wum747349-debug/LiIon-Charger-Protection-Board/hardware/README.md

# 硬件源文件与证据

只有实际工作或证据产生后，才创建对应的硬件子目录：

- `altium_project/`：权威 `.PrjPcb`、`.SchDoc`、`.PcbDoc` 和必要的项目库；
- `outputs/`：可追溯的原理图 PDF、BOM、报告和制造输出；
- `images/`：审查、装配、上电调试、测试和展示图片。

`.SchDoc` 和 `.PcbDoc` 是权威 EDA 实现源。目录、PDF、图片或文字设计意图不能证明 ERC、DRC、规则命中、铺铜状态或制造放行。用户负责实际 Altium 操作和导出；AI/Codex 只在明确限制下分析用户提供的证据。

不得仅为目录完整而创建空输出分类或低信息量占位文件。
