wum747349-debug/LiIon-Charger-Protection-Board/docs/module_design/README.md

# Stage 3 — Module Design Records

Status: Stage 3 documentation closeout complete — `READY FOR SCHEMATIC REVIEW`

## Current progress

| Module | Current status | Record |
| --- | --- | --- |
| M1 — USB-C Input / CC / Current Capability Control | COMPLETE FOR STAGE-3 HANDOFF | [m1_usb_c_input_cc_current_control.md](m1_usb_c_input_cc_current_control.md) |
| M2 — BQ25185 Charger / Power Path | COMPLETE FOR STAGE-3 HANDOFF | [m2_charger_power_path.md](m2_charger_power_path.md) |
| M3 — Battery + External NTC | COMPLETE FOR STAGE-3 HANDOFF | [m3_battery_external_ntc.md](m3_battery_external_ntc.md) |
| M4 — 3.3V Buck-Boost | COMPLETE FOR STAGE-3 HANDOFF | [m4_3v3_buck_boost.md](m4_3v3_buck_boost.md) |
| M5 — 3.3V Output Protection | COMPLETE FOR STAGE-3 HANDOFF | [m5_3v3_output_protection.md](m5_3v3_output_protection.md) |
| M6 — Remaining interfaces / support | COMPLETE FOR STAGE-3 HANDOFF | [m6_remaining_interfaces_support.md](m6_remaining_interfaces_support.md) |

用户已在 Altium Designer 中完成当前 M1–M6 Rev.A capture。Final Schematic Review、Cross-Module Integration Review 与 BOM Consistency Review 已完成；未发现新的 substantive cross-module electrical logic issue。Stage 5 documentation sync 已记录 M1/M5 current designator 与 L1 component delta；新 L1 footprint/pad mapping 仍需 EDA verification。Stage 3 canonical readiness 为 `READY FOR SCHEMATIC REVIEW`，技术评估为 `READY WITH MINOR NOTES`。

## Final passive / BOM baseline

- Ordinary resistors: `0603 / 1% preferred`; M5 `R14 = 3.32kΩ / 1% / 1206`.
- Ordinary small capacitors: `0603`.
- `C1 = 10uF / 25V / 0805`; `C2 = 2.2uF / 25V / 0603`.
- M4 `C11 = 10uF / 0805`; M5 `C5 = 10uF / 0805`.
- `C14,C15 = 22uF / 0805`; `C13 = 1nF / high-voltage / 1206`.
- M5 `C4,C6 = 100nF`; `C7 = 330nF`; `C8 = 2.2nF`.
- `L1 = Murata DFE201612E-R47M=P2 / 470nH / LCSC C668312`; new footprint/pad mapping requires Stage 5 EDA verification.

Exact MPN / LCSC sourcing for ordinary commodity resistors and capacitors may remain deferred to Manufacturing Preparation. Placeholder or garbage BOM metadata, if present, is a manufacturing/BOM metadata cleanup item and is not a schematic electrical blocker.

## Evidence boundary

`.SchDoc` 仍是 authoritative implementation source。最新版 schematic/BOM 已完成 review 与 consistency sync，但仓库当前没有 ERC report，因此 `ERC = NOT YET VERIFIED`。不声称 `ERC PASS`、PCB DRC、simulation、layout verification、manufacturing、hardware measurement、bring-up 或 temperature trip 已验证。TPS63802 低于自身 UVLO 时 PG 的 datasheet-defined `Undefined` 边界仍须 Bring-up 示波器验证；M5 UV/OV threshold、1A/100ms transient、hard short、thermal 与 latch/reset behavior 也均未实测。
