wum747349-debug/LiIon-Charger-Protection-Board/docs/module_design/m3_battery_external_ntc.md

# M3 — Battery + External NTC

Status: `COMPLETE FOR STAGE-3 HANDOFF`

## Battery interface

The current schematic baseline is `J_BAT1 = HX-XH2.54-2PZZ`: pin 1 connects to BAT and pin 2 to GND; BAT also connects to the physical test-point component `TP_BAT`. `J_NTC1 = HX-XH2.54-2PZZ`: pin 1 connects to the R15 / external NTC path and pin 2 to GND. The selected NTC cable interface uses `C5221417`, an HX 2.54-2P DT, 200mm, 24AWG pre-crimped 2-pin female harness. Although the NTC itself is non-polarized, the maintenance convention is red → J_NTC1 pin 1 → R15 / `NTC_TS`, black → J_NTC1 pin 2 → GND. Using the same board connector type for BAT and NTC requires clear silkscreen and physical-placement differentiation, but does not provide mechanical foolproofing. The connector specification is electrically adequate at approximately 3A / 250V and its PCB pitch drawing is 2.5mm; this does not verify the actual battery accessory. Battery exact mating compatibility and battery polarity/wire order remain `PHYSICAL VERIFICATION PENDING`; both must be verified before the first actual battery connection, including a multimeter polarity check. Red/black wires or product images do not verify battery polarity.

## External NTC and NTC_TS network

Rev.A uses the selected Nanjing Shiheng `MF52D 103F3435-100` / LCSC `C394023`: external epoxy/wired NTC, `10kΩ @25℃`, R25 tolerance `±1%`, B25/85 `3435K`, Beta tolerance `±1%`, with 100mm insulated leads. It must be electrically insulated and attached without puncturing, compressing or otherwise damaging the pouch; final placement and attachment remain mechanical inputs.

- `U1 pin 6 TS/MR → NTC_TS → TP_NTC_TS`.
- `NTC_TS → R15 2.7kΩ / 1% → J_NTC1 pin 1`; `J_NTC1 pin 2 → GND`.
- External `TH1 10k/B3435` connects between J_NTC1 pins 1 and 2.

R15 is primarily mitigation against an external NTC short pulling TS/MR directly near 0V, reducing TS/MR push-button / long-low / factory-mode interaction risk; it is not presented as a precision calibration resistor.

## High-temperature comparator interlock

U3 is the ordinary `TLV7041DBVR`, whose current design-record pin mapping is pin 1 OUT, pin 2 V-, pin 3 IN+, pin 4 IN-, pin 5 V+. It must not be confused with differently pinned TLV7041S / TLV7041L variants. `U5 = TPS63802DLAR` belongs to M4.

- Supply: `pin 5 V+ → 3V3`, `pin 2 V- → GND`; local `C9 = 100nF` from 3V3 to GND.
- Positive input: `pin 3 IN+ → NTC_TS`.
- Reference: `3V3 → R16 90.9kΩ / 1% → VHOT_REF → R17 10kΩ / 1% → GND`; `VHOT_REF → pin 4 IN-`. Nominal reference is approximately 0.327V.
- Open-drain output: `pin 1 OUT → CHG_GATE`; `CHG_ENABLE_CMD → R6 10kΩ → CHG_GATE`; `CHG_GATE → R7 100kΩ → GND`, TPS63802 open-drain PG, and Q1 gate. `CHG_ENABLE_CMD` is the only HIGH authorization source; TLV7041 OUT and TPS63802 PG are independent LOW veto sources. The required current design remains the ordinary open-drain `TLV7041DBVR`, not the push-pull `TLV7031DBVR` discussed during intermediate capture.

At normal temperature, `NTC_TS > VHOT_REF`, U3 OUT is high impedance, and a HIGH `CHG_ENABLE_CMD` may turn Q1 on and pull CE# low. For over-temperature or another relevant low-NTC_TS fault, U3 pulls `CHG_GATE` low, Q1 turns off, and R3 pulls CE# high to inhibit charging.

## Temperature interpretation and fault behavior

The Battery Design Basis remains the product-spec charging range of approximately 0℃–45℃. The present Stage 3 circuit is an engineering implementation with a conservative nominal hardware charge-temperature window of approximately 4℃–39℃, not a new manufacturer specification or a verified exact trip range. Resistor, comparator-threshold and NTC tolerances, pouch thermal lag and hardware testing remain unresolved; actual trip temperatures are `Planned for Bring-up / Test`.

- Too cold: BQ25185 native TS COLD behavior inhibits charging.
- Too hot: TLV7041 pulls `CHG_GATE` low, making Q1 OFF and CE# HIGH.
- NTC short: R15 avoids a direct hard short of TS/MR to GND; TLV7041 qualification is intended to revoke charge enable.
- NTC open/disconnected: BQ25185 native TS behavior owns abnormal handling.
- Temperature faults revoke charging qualification only; they do not disable the valid USB-to-SYS Power Path.

## Open integration and evidence boundary

M1 defines `CHG_ENABLE_CMD = NAND(CC_OUT1, CC_OUT2)`, so unattached state revokes charge enable and every qualified attached current-advertisement state may authorize the shared node. M3 TLV7041 and M4 TPS63802 PG then independently veto LOW, implementing `CHG_ENABLE_CMD AND temperature-valid AND 3V3-power-good → charging permitted`. Cross-Module Integration is complete with no new substantive electrical logic issue. The earliest startup transient remains open because TPS63802 PG is datasheet-defined `Undefined` below its own UVLO; it requires Bring-up oscilloscope verification and is not an absolute fail-safe or measured PASS claim. NTC exact selection and harness interface are frozen; final NTC attachment, actual trip-temperature tests, pouch thermal lag, battery pre-first-connection physical verification and PCB/hardware verification remain OPEN. ERC is `NOT YET VERIFIED`.
