wum747349-debug/LiIon-Charger-Protection-Board/docs/module_design/m4_3v3_buck_boost.md

# M4 — 3.3V Buck-Boost

Status: `COMPLETE FOR STAGE-3 HANDOFF`

## Responsibility and interfaces

M4 converts `SYS` to the regulated `3V3` rail with the Stage 2 Primary `TPS63802DLAR`. It accepts power from M2 at `SYS`, supplies the downstream 3.3V domain, and contributes the regulator power-good qualification to the shared `CHG_GATE` charging-permission node. The current connection record is user-reported / screenshot-reviewed schematic capture, not verified parsing of the authoritative `.SchDoc`.

## TPS63802 connection baseline

| Pin | Name | Current connection |
| --- | ---- | --- |
| 1 | EN | `SYS` |
| 2 | MODE | `GND` |
| 3 | AGND | `GND` |
| 4 | FB | `FB_3V3` |
| 5 | PG | `CHG_GATE` |
| 6 | VOUT | `3V3` |
| 7 | L2 | one side of `L1 DFE201612E-R47M=P2`, `470nH`; the other side connects to pin 9 L1 |
| 8 | GND  | `GND` |
| 9 | L1 | one side of `L1 DFE201612E-R47M=P2`, `470nH`; the other side connects to pin 7 L2 |
| 10  | VIN  | `SYS` |

The single current exact inductor baseline is `L1 = Murata DFE201612E-R47M=P2`, `470nH`, LCSC `C668312`, connected `TPS63802 pin 9 L1 ↔ L1 470nH ↔ TPS63802 pin 7 L2`. This replacement was accepted during the Stage 5 procurement/component delta review; the former XFL4015-471MEC baseline is historical and superseded.

The input capacitor is `C11 = 10uF / 0805` from `SYS` to GND. The output network is `C14,C15 = 22uF / 0805` from `3V3` to GND. The feedback divider is `3V3 → R20 511kΩ / 1% → FB_3V3 → R22 91kΩ / 1% → GND`.

These values are the current Stage 3 schematic baseline. They do not constitute measured ripple, transient, current-stress, thermal or stability evidence.

## PG and CHG_GATE integration

The final simple charging qualification is:

`CHG_ENABLE_CMD → R6 10kΩ → CHG_GATE`

The same node also has `R7 100kΩ: CHG_GATE → GND`, `TLV7041DBVR OUT → CHG_GATE`, `TPS63802 PG → CHG_GATE`, and `CHG_GATE → charge-enable MOSFET gate`. `CHG_ENABLE_CMD` is the only HIGH authorization source. The ordinary `TLV7041DBVR` OUT and TPS63802 PG are open-drain LOW veto sources; neither authorizes charging HIGH. TPS63802 PG has no separate `3V3` pull-up, and this design does not add `TPS3808G33DBVR` / U6.

The intended qualification is:

`CHG_ENABLE_CMD AND temperature-valid AND 3V3-power-good → charging permitted`

Normal 3V3 startup, brownout and temperature-veto architecture is therefore substantially resolved. This is not an absolute fail-safe startup claim: while TPS63802 input is still below its own UVLO during the earliest startup interval, the datasheet defines a boundary in which PG is `Undefined`. Earliest startup transient behavior remains open for Bring-up oscilloscope verification. Recommended simultaneous observations are `VBUS / SYS / 3V3 / PG / CHG_ENABLE_CMD / CHG_GATE / CE#`.

## Layout-sensitive notes

- Verify the new L1 footprint, pad geometry and pin/pad mapping in Altium before placement; status is `REQUIRES EDA VERIFICATION`.
- Keep the `470nH` inductor and the VIN/VOUT ceramic capacitors close to the TPS63802 power pins, with compact switch/high-di/dt loops.
- Keep the `FB_3V3` node and 511kΩ/91kΩ divider away from the switch nodes and inductor; use a quiet ground reference for the lower divider resistor.
- Provide a low-impedance ground implementation that respects the separation and local return needs of AGND and power GND before their intended common reference.
- Route PG/`CHG_GATE` as a control node away from the L1/L2 switch nodes, and preserve access to the startup-observation nets for Bring-up.
- Final placement, copper, thermal behavior, footprint/pad mapping and manufacturer layout guidance compliance remain subject to later EDA and PCB review.

## Open evidence boundary

- Schematic capture basis: user-reported / screenshot-reviewed.
- Actual `.SchDoc` pin mapping: `NOT VERIFIED`.
- ERC: `NOT YET VERIFIED`.
- Latest schematic/BOM review baseline: `SYNCHRONIZED`.
- Hardware startup sequencing: `NOT MEASURED`.
- Inductor selection: current device `DFE201612E-R47M=P2 / 470nH / C668312`; footprint/pad mapping, thermal, transient, efficiency and PCB-layout behavior are `NOT VERIFIED`.
- 500mA continuous and 1A/100ms transient hardware verification: `NOT RUN`.

M4 is complete for the Stage 3 handoff at the documented design-record level. This does not claim `ERC PASS`, Stage 4 PASS, PCB/layout verification or hardware verification.
