wum747349-debug/LiIon-Charger-Protection-Board/FRAMEWORK.md

# Framework Binding

Framework Repository: wum747349-debug/Hardware-Project-Framework
Framework Release: hardware-project-framework-v1.1.1
Framework Commit: e139ce90b74e391a6a46e30ff7e14aebf8487b84
Project Structure Version: 1
Repository Model: Standalone Project
Initialization Framework Release: development-v0.9
Initialization Status: Initialized

This Project is bound to the published immutable Framework Release and commit above and does not follow Framework `main`. Its initialization provenance remains `development-v0.9`.
