wum747349-debug/LiIon-Charger-Protection-Board/docs/pcb_review.md

# PCB Layout / Routing / Release Review Record

## Review Identity

- Hardware: Rev.A
- Stage 7 — PCB Release Review: `COMPLETE / PASS`
- Stage 7 closeout transition: manufacturing was approved, the board order was submitted, and the project entered Stage 8
- Evidence boundary at closeout: no assembly, power-on, or bring-up evidence existed yet
- Stage 6 B3 Layout / Routing Review: `CLOSED / PASS`

## Evidence Boundary

- `.PcbDoc` is the EDA implementation authority.
- User-confirmed Altium configuration and Batch DRC are implementation evidence.
- PCB screenshots support visual assessment of placement, routing, copper continuity, and labeling but do not independently prove exact net identity or geometry.
- Final Gerber / Drill manufacturing data and the JLCPCB manufacturing interpretation were reviewed before the manufacturing order was submitted.

## Stage 5 Closeout

| Item | Status |
| --- | --- |
| Manufacturing baseline | `COMPLETE` |
| Mechanical baseline | `COMPLETE` |
| Board outline / mounting-hole baseline | `CONFIRMED` |
| Connector orientation | `CONFIRMED` |
| Critical footprint / pin-pad mapping | `CONFIRMED BY USER IN ALTIUM` |
| Whole-board placement | `COMPLETE / FROZEN` |
| Stage 5 | `COMPLETE / PASS` |

## Stage 6 — Routing and Copper Closeout

The final interactive review used the user's current local PCB screenshots, Top / Bottom GND Polygon views, Bottom routing view, and the current Batch DRC report. The final Rev.A EDA source is synchronized and frozen in the Stage 7 closeout commit.

| Review item | Result |
| --- | --- |
| Major routing complete | `PASS` |
| Un-Routed Nets | `PASS — 0` |
| Short Circuit | `PASS — 0` |
| Clearance | `PASS — 0` |
| POWER Width `8 / 20 / 100 mil` | `PASS — 0` |
| Default Width | `PASS — 0` |
| Modified Polygon | `PASS — 0` |
| GND Polygon / Repour | `PASS` |
| Bottom GND plane continuity | `PASS BY VISUAL REVIEW — no identified plane-splitting blocker` |
| GND via / stitching | `PASS / COMPLETE FOR STAGE 6` |
| Hole-To-Hole | `PASS — 0` |
| Minimum Solder Mask Sliver | `PASS — 0` |
| Net Antennae | `PASS — 0` |
| Large-scale placement reopen required | `NO` |
| Large-scale rerouting required | `NO` |

### Stage 6 Conclusion

`Stage 6 — Routing and Copper: COMPLETE`

`B3 — Layout / Routing Review: PASS`

`Approved to enter: Stage 7 — PCB Release Review / Manufacturing Preparation`

No identified electrical / routing / copper blocker requires reopening Placement or Routing. Further PCB edits should be driven only by a concrete Stage 7 manufacturing-output finding.

## Final Full Batch DRC Summary

Status: `COMPLETE / REVIEWED`

User-provided Altium Design Rule Verification Report for the final Rev.A release candidate:

```text
Date: 2026-08-25
Time: 21:31:22
Warnings: 0
Rule Violations: 213

Clearance                    0
Short Circuit                0
Un-Routed Nets               0
Modified Polygon             0
Width — POWER                0
Width — Default              0
Power Plane Connect          0
Hole Size                    4
Hole-To-Hole                 0
Minimum Solder Mask Sliver   0
Silk To Solder Mask          200
Silk To Silk                 9
Net Antennae                 0
Height                       0
```

### DRC Finding Classification

#### RL-001 — Four M3 NPTH Hole Size Rule Hits

- Objects: four mechanical mounting holes.
- Actual hole: approximately 3.20 mm / 125.984 mil.
- Plating: `OFF` / NPTH as confirmed by user in Altium.
- Cause: current global Hole Size rule has Max = 100 mil.
- Engineering disposition: mounting-hole size is intentional; do not reduce the M3 holes merely to satisfy the electrical-hole global rule.
- User decision: user explicitly chose not to create a dedicated Hole Size Rule exception.
- Final manufacturing viewer confirmed that the four M3 mounting holes are represented as intended NPTH / non-plated mechanical holes.
- Finding disposition: `CLOSED / ACCEPTED`.

#### RL-002 — Silkscreen DRC Findings

- `Silk To Solder Mask = 200`.
- `Silk To Silk = 9`.
- User decision: user explicitly chose not to perform broad silkscreen cleanup.
- The DRC report contains ordinary component designator / footprint-outline conflicts and a limited number of meaningful labels such as `J_BAT1`, `TP_NTC_TS1`, and `TP_VBUS_PROT1`.
- Critical marking review was completed in the final manufacturing viewer. Required connector, polarity, Pin 1, power, GND, and critical TP information remained understandable.
- Ordinary silkscreen DRC findings are accepted under the previously approved waiver.
- Finding disposition: `CLOSED / WAIVER ACCEPTED`.

## Final Rev.A Rule Decisions Recorded for Release

- `Width_Power = Min 8 mil / Preferred 20 mil / Max 100 mil`.
- Scope: `InNetClass('POWER')`.
- 8 mil is only a short small-pad escape / local neck-down minimum, not the preferred whole-route power width.
- `Width_Default = 6 / 8 / 40 mil`.
- Top / Bottom GND Polygon: Solid Pour.
- `Remove Islands Less Than = 2500 sq.mil`.
- `Remove Necks Less Than = 10 mil`.
- `Remove Dead Copper = enabled`.
- GND stitching strategy: targeted functional / return-path / local copper stitching, not a board-wide fixed grid.

## Stage 7 — PCB Release Review Closeout

| Release item | Closeout status |
| --- | --- |
| PCB design frozen for manufacturing | `YES` |
| Final Full Batch DRC reviewed | `YES` |
| Electrical / routing DRC blockers | `NONE IDENTIFIED` |
| Four M3 NPTH Hole Size hits | `CLOSED / ACCEPTED` |
| Silkscreen findings | `CLOSED / WAIVER ACCEPTED` |
| PCB rule documentation synchronized | `YES` |
| Gerber generated from final PCB | `GENERATED / REVIEWED` |
| NC Drill generated from final PCB | `GENERATED / REVIEWED` |
| Actual manufacturing-data path | `CONFIRMED` |
| JLCPCB manufacturing interpretation | `PASS` |
| PCB / BOM / manufacturing-output version consistency | `CONFIRMED` |
| Final manufacturing parameters | `CONFIRMED` |
| Manufacturing Release Decision | `批准制造` |
| Manufacturing order | `SUBMITTED` |
| Stage 7 | `COMPLETE` |

## Completed Gerber / Drill Release Review

The final Gerber / Drill manufacturing data generated from the frozen Rev.A PCB was inspected through the actual JLCPCB submission and manufacturing-viewer path before ordering.

Completed viewer checks:

1. **Board outline** — one closed 55 mm × 35 mm outline with intended rounded corners; no duplicate or stray outline segments.
2. **Top Copper** — all primary routing / copper visible; no missing polygons, accidental copper cutouts, or stray copper outside the board.
3. **Bottom Copper** — continuous GND plane remains visibly continuous except for intended limited routing clearance; no unexpected large split / island.
4. **Top Solder Mask** — openings exist only where solderable pads / intended exposed copper require them; no unexpected large missing-mask region.
5. **Bottom Solder Mask** — inspect vias / through-holes / bottom pads and ensure no unexpected openings.
6. **Top Silkscreen** — `J_BAT1`, `J_NTC1`, `J_OUT1`, critical polarity / Pin 1, `3V3`, `GND`, and important TP labels remain understandable after clipping to solder mask.
7. **Drill / PTH** — normal plated holes / vias appear in the plated drill output as expected.
8. **Drill / NPTH** — four M3 mounting holes appear as non-plated mechanical holes, approximately 3.20 mm, in the NPTH / mechanical drill representation.
9. **Layer registration** — copper, mask, silk, outline, and drill are aligned to the same board origin / orientation.
10. **Package hygiene** — manufacturing archive contains only current Gerber / Drill files; no old Gerbers, previews, logs, cache, or obsolete duplicate outputs.

## Manufacturing Release Decision

Closeout conclusion: `批准制造`.

Actual manufacturing-data / submission path:

`Final Rev.A .PcbDoc → exported Gerber / Drill manufacturing data → JLCPCB submission → JLCPCB manufacturing viewer → final interpretation review → manufacturing order`.

- Exact release candidate: final Rev.A EDA source synchronized in the Stage 7 closeout commit.
- Final release candidate: `CONFIRMED`.
- Final Full Batch DRC: `COMPLETE / REVIEWED`.
- Gerber / NC Drill: `GENERATED / REVIEWED`.
- JLCPCB manufacturing interpretation: `PASS`.
- Manufacturing parameters and PCB / BOM / manufacturing-output version consistency: `CONFIRMED`.
- Manufacturing order: `SUBMITTED`.
- Stage 7 — PCB Release Review: `COMPLETE / PASS`.
- Stage 8 transition at closeout: `ENTERED — no assembly, power-on, or bring-up evidence existed at that time`.
