wum747349-debug/LiIon-Charger-Protection-Board/hardware/outputs/LiIon Charger Protection Board BOM表.xlsx

Comment | Description | Designator | Footprint | LibRef | Quantity
10uF | 容值:10uF;精度:±10%;额定电压:25V;温度系数:X5R; | C1, C5, C11 | C0805 | CL21A106KAYNNNE_C15850 | 3
2.2uF | 容值:2.2uF;精度:±10%;额定电压:25V;温度系数:X5R; | C2 | C0603 | CL10A225KA8NNNC | 1
1µF |  | C3 | C0603 | CAP_0603 | 1
100nF |  | C4, C6, C9, C10, C12 | C0603 | CAP_0603 | 5
330nF |  | C7 | C0603 | CAP_0603 | 1
2.2nF |  | C8 | C0603 | CAP_0603 | 1
1nF | 容值:1nF;精度:±5%;额定电压:1kV;温度系数:C0G; | C13 | C1206 | GRM31C5C3A102JWA3L | 1
22uF | 容值:22uF;精度:±20%;额定电压:25V;温度系数:X5R; | C14, C15 | C0805 | GRM21BR61E226ME44L | 2
PESD5V0U2BT,215 | 极性:双向;反向截止电压(Vrwm):5V;击穿电压:5.5V; | D1 | SOT-23-3_L2.9-W1.6-P1.90-LS2.8-BR | PESD5V0U2BT,215 | 1
SMF6.0A | 极性:单向;反向截止电压(Vrwm):6V;钳位电压:10.3V;峰值脉冲电流(Ipp):19.4A@10/1000us;峰值脉冲功率(Ppp):200W@10/1000us;击穿电压(VBR):7.37V; | D2 | SOD-123FL_L2.7-W1.8-LS3.8-RD | SMF6.0A_C207260 | 1
BAT54,215 | 正向压降(Vf):800mV@100mA;直流反向耐压(Vr):30V;整流电流:200mA; | D3 | SOT-23_L2.9-W1.3-P1.90-LS2.4-BR | BAT54,215 | 1
HX-XH2.54-2PZZ | 插针结构:1x2P;间距:2.54mm;安装方式:直插;参考系列:XH;总PIN数:2P;排数:1;每排PIN数:2;行距:-;额定电流:3A;触头材质:黄铜;触头镀层:锡;工作温度:-25℃~+85℃; | J_BAT1, J_NTC1 | CONN-TH_2P-P2.50_HX-2.54MM-2P-ZZ-MS | HX-XH2.54-2PZZ | 2
KF301-5.0-2P | 结构:1x2P;间距:5mm;颜色:蓝色;安装方式:直插;排数:1;每排PIN数:2;额定电流:17A;额定电压:250V;线规 - AWG:14~22;线规 - 平方毫米:1.5;工作温度:-30℃~+120℃; | J_OUT1 | CONN-TH_P5.00_KF301-5.0-2P | KF301-5.0-2P | 1
470nH | 电感值:470nH;精度:±20%;额定电流:4.5A;饱和电流(Isat):5.5A; | L1 | IND-SMD_L2.0-W1.6-1 | DFE201612E-R47M=P2 | 1
2N7002BK,215 | 数量:1个N沟道;漏源电压(Vdss):60V;连续漏极电流(Id):350mA;导通电阻(RDS(on)):1.6Ω@10V;耗散功率(Pd):370mW;阈值电压(Vgs(th)):2.1V; | Q1, Q2 | SOT-23-3_L3.0-W1.7-P0.95-LS2.9-BR | 2N7002BK,215 | 2
600Ω | 阻值:600Ω;精度:±1%;功率:500mW;工作电压:150V;温度系数:±100ppm/℃; | R1 | R0805 | CRCW0805600RFKEAHP | 1
75kΩ | 电阻类型:厚膜电阻;阻值:75kΩ;精度:±1%;功率:100mW;工作电压:75V;温度系数:±100ppm/℃; | R2 | R0603 | 0603WAF7502T5E | 1
47kΩ | 电阻类型:厚膜电阻;阻值:47kΩ;精度:±1%;功率:100mW;工作电压:75V;温度系数:±100ppm/℃; | R3 | R0603 | FRC0603F4702TS | 1
13kΩ | 电阻类型:厚膜电阻;阻值:13kΩ;精度:±1%;功率:100mW;工作电压:75V;温度系数:±100ppm/℃; | R4 | R0603 | 0603WAF1302T5E | 1
100k |  | R5, R21, R23 | R0603 | Res_0603 | 3
10kΩ |  | R6 | R0603 | Res_0603 | 1
100 kΩ |  | R7, R12 | R0603 | Res_0603 | 2
4.99kΩ | 电阻类型:厚膜电阻;阻值:4.99kΩ;精度:±1%;功率:100mW;工作电压:75V;温度系数:±100ppm/℃; | R8 | R0603 | 0603WAF4991T5E | 1
8.25kΩ | 电阻类型:厚膜电阻;阻值:8.25kΩ;精度:±1%;功率:100mW;工作电压:75V;温度系数:±100ppm/℃; | R9 | R0603 | FRC0603F8251TS | 1
47k |  | R10 | R0603 | Res_0603 | 1
49.9kΩ | 电阻类型:厚膜电阻;阻值:49.9kΩ;精度:±1%;功率:100mW;工作电压:75V;温度系数:±100ppm/℃; | R11 | R0603 | 0603WAF4992T5E | 1
54.9kΩ | 电阻类型:厚膜电阻;阻值:54.9kΩ;精度:±1%;功率:100mW;最大工作电压:75V;温度系数:±100ppm/℃; | R13 | R0603 | 0603WAF5492T5E | 1
3.32kΩ | 电阻类型:厚膜电阻;阻值:3.32kΩ;精度:±1%;功率:100mW;工作电压:75V;温度系数:±100ppm/℃; | R14 | R0603 | FRC0603F3321TS | 1
2.7kΩ | 电阻类型:厚膜电阻;阻值:2.7kΩ;精度:±1%;功率:100mW;工作电压:75V;温度系数:±100ppm/℃; | R15 | R0603 | FRC0603F2701TS | 1
90.9kΩ | 电阻类型:厚膜电阻;阻值:90.9kΩ;精度:±1%;功率:100mW;工作电压:75V;温度系数:±100ppm/℃; | R16 | R0603 | FRC0603F9092TS | 1
10K |  | R17 | R0603 | Res_0603 | 1
910kΩ | 电阻类型:厚膜电阻;阻值:910kΩ;精度:±1%;功率:100mW;工作电压:75V;温度系数:±100ppm/℃; | R18 | R0603 | FRC0603F9103TS | 1
1MΩ | 电阻类型:厚膜电阻;阻值:1MΩ;精度:±1%;功率:250mW;最大工作电压:200V;温度系数:±100ppm/℃; | R19 | R1206 | RC1206FR-071ML | 1
511kΩ | 电阻类型:厚膜电阻;阻值:511kΩ;精度:±1%;功率:100mW;工作电压:75V;温度系数:±100ppm/℃; | R20 | R0603 | FRC0603F5113TS | 1
91kΩ | 电阻类型:厚膜电阻;阻值:91kΩ;精度:±1%;功率:100mW;工作电压:75V;温度系数:±100ppm/℃; | R22 | R0603 | FRC0603F9102TS | 1
 | Test Point 测试点 | TP_3V3, TP_3V3_PROT1, TP_BAT1, TP_CE_N1, TP_CHG_GATE1, TP_GND1, TP_M5_RESET1, TP_NTC_TS1, TP_SYS1, TP_VBUS_PROT1 | Test-Point-0.5mm | Test-Point | 10
BQ25185DLHR | 工作电压:3V~18V;最大充电电流:1A;电池类型:锂电池；磷酸铁锂电池;电池节数:1; | U1 | WSON-10_L2.2-W2.0-P0.40-BL-EP_TI_DLH0010A | BQ25185DLHR | 1
TPS259474LRPWR | 工作电压:2.7V~23V; | U2 | VQFN-10_L2.0-W2.0-P0.45-TL | TPS259474LRPWR | 1
TLV7041DBVR | 比较器数:单路;输入失调电压(Vos):100uV;输入偏置电流(Ib):2pA;轨到轨:轨到轨输入; | U3 | SOT-23-5_L2.9-W1.6-P0.95-LS2.8-BR | TLV7041DBVR | 1
SN74LVC2G132DCUR | 逻辑类型:与非门;通道数:2;工作电压:1.65V~5.5V;静态电流(Iq):10uA;传播延迟(tpd):5ns@5V,50pF; | U4 | US-8_L2.4-W2.1-P0.50-LS3.2-BR | SN74LVC2G132DCUR | 1
TPS63802DLAR | 功能类型:升降压型;工作电压:1.3V~5.5V;输出电压:1.8V~5.2V;输出电流:2A;输出类型:可调; | U5 | VSON-10_L3.0-W2.0-P0.50-TL | TPS63802DLAR_C2845237 | 1
TUSB320LAIRWBR | 工作电压:2.7V~5V;最大充电电流:3A;电池类型:-;电池节数:-; | U6 | X2QFN-12_L1.6-W1.6-P0.40-TL | TUSB320LAIRWBR | 1
TYPE-C-31-M-12 | 连接器类型:Type-C;协议标准:-;公母:母;安装方式:卧贴;触点数量:16P;端口数量:1;额定电流 - 电源:5A;工作温度:-30℃~+80℃; | USBC1 | USB-C_SMD-TYPE-C-31-M-12_1 | TYPE-C-31-M-12 | 1
