wum747349-debug/LiIon-Charger-Protection-Board/hardware/outputs/原理图.pdf

1

2

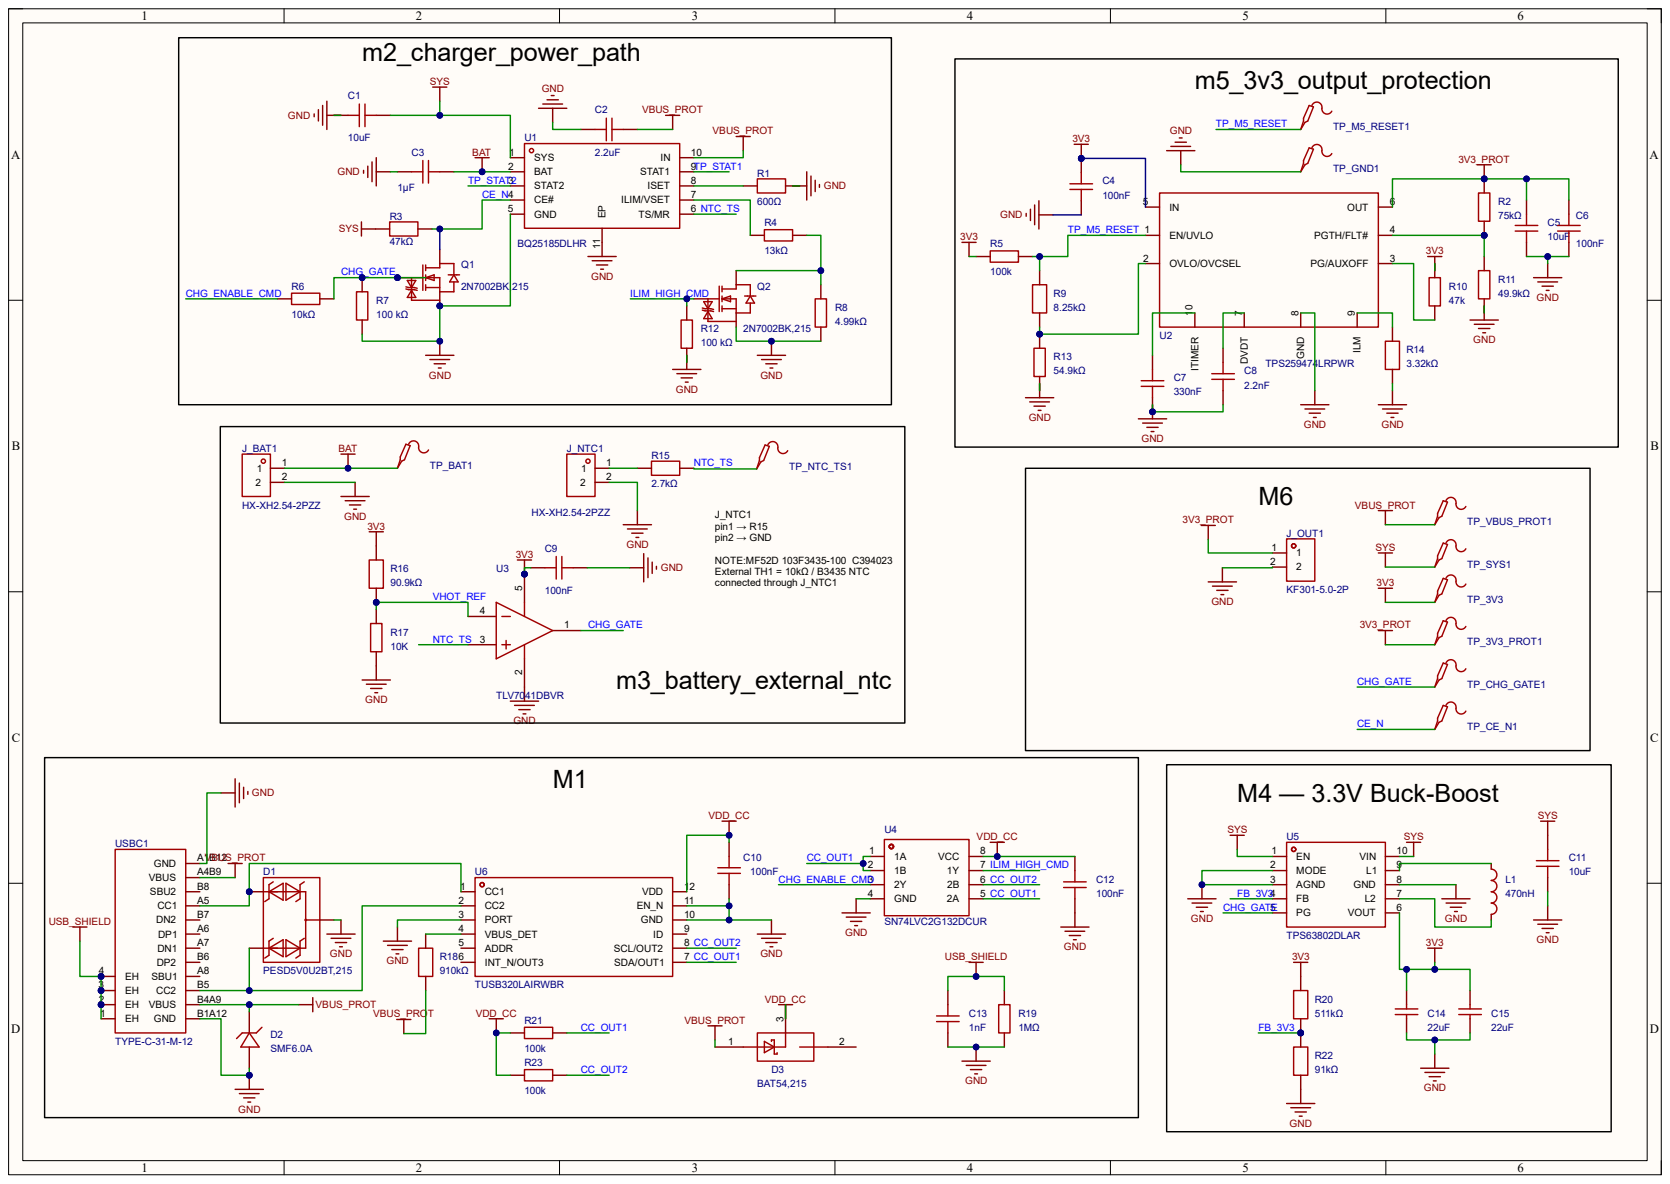
[picture p1: page 1]
