wum747349-debug/LiIon-Charger-Protection-Board/(list of files, drawings)

Other design files:
hardware/altium_project/LiIon Charger Protection Board.PcbDoc
hardware/altium_project/LiIon Charger Protection Board.PrjPcb
hardware/altium_project/LiIon Charger Protection Board.SchDoc
hardware/altium_project/LiIon Charger Protection Board.SchLib
hardware/altium_project/PCB1.PcbLib
hardware/LiIon Charger Protection Board/LiIon Charger Protection Board.PcbDoc
hardware/LiIon Charger Protection Board/LiIon Charger Protection Board.PrjPcb
