wum747349-debug/LiIon-Charger-Protection-Board/(commit log)

2026-08-04 chore: bootstrap standalone project from framework snapshot
2026-08-05 docs: establish Stage 1 requirements baseline
2026-08-09 docs: separate stage and authority cutover gates
2026-08-09 chore: migrate framework binding to rc1
2026-08-09 docs: clarify initial framework migration provenance
2026-08-11 docs: update stage 2 component selection baseline
2026-08-12 docs: close stage 2 and enter schematic design
2026-08-12 chore: pin project 2 to framework v1.1 evaluation
2026-08-12 chore: repin framework v1.1 evaluation
2026-08-13 Repin Framework evaluation snapshot
2026-08-13 docs: record stage 3 m2 m3 circuit design
2026-08-14 chore: repin project 2 framework snapshot
2026-08-14 docs: sync Stage 3 M1 design facts
2026-08-15 docs: sync M4 Stage 3 integration facts
2026-08-15 docs: record stage 3 m5 output protection design
2026-08-16 docs: sync stage 3 m6 interface and support design
2026-08-16 docs: close out stage 3 schematic records
2026-08-19 docs: close stage 4 schematic review
2026-08-21 docs: sync stage 5 component delta baseline
2026-08-21 chore: add current altium pcb workspace
2026-08-21 chore: clean stage 5 design records and altium workspace
2026-08-21 docs: freeze Rev.A PCB rule baseline
2026-08-22 chore: correct project 2 framework commit
2026-08-22 docs: close Stage 5 layout preflight
2026-08-23 docs: define simplified PCB rule baseline
2026-08-25 chore: repin development framework evaluation
2026-08-25 docs: enter pcb release review
2026-08-25 docs: sync final pcb rule baseline
2026-08-25 docs: close stage 6 and open release review
2026-08-29 chore: adopt framework v1.1.1
2026-08-29 docs: close stale pcb release status
2026-09-05 docs: prepare stage 8 bring-up plan
2026-09-05 docs: enter stage 8 assembly preparation
2026-09-05 docs: sync README with finalized bring-up flow
2026-09-05 docs: clarify Stage 8 execution authority
2026-10-02 docs: update Rev.A Stage 8 bring-up status
2026-10-02 docs: align battery connector status with bring-up evidence
2026-10-30 docs: record TPS63802 light-load USB and battery ripple observations
